akshita-gangiredla/sun-tracking-for-solar-panels/README.md

# sun-tracking-for-solar-panels
It covers physical wiring, flashing each microcontroller with the correct file from the accompanying code package, and testing each piece before relying on it.
